orthopus/01-myohand/docs/hardware/STU-0113 - Assembly plan v1_2 [FR].xlsx

Composants | Origine | Post-opération
Arbre intermédiaire 1
Paliers | Commerce | Coupe
Plaque int | Impression ALU | Perçage - Taraudage
Arbre | Commerce | Coupe
Roue entrée | Commerce | Coupe ?
Roue héli | Commerce | Coupe ?
Support roulement sup | Impression ALU | Alésage - Taraudage
Arbre intermédiaire 2
Engrenages | Commerce | Coupe - Perçage - Assemblage
Paliers engrenages | Commerce | -
Poulie | Impression ALU | Perçage
Paliers poulie | Commerce | Coupe
Arbre | Commerce | Coupe - Perçage - Taraudage
Arbre moteur
Arbre | Commerce | Coupe - Perçage - Taraudage
Vis sans fin | Commerce | Coupe
Entretoises | Impression PLA | Impression
Roulements | Commerce | -
Support moteur
Embase | Impression ALU | Perçage - Taraudage
Moteur | Commerce | -
Support roulement inf | Impression ALU | Alésage - Taraudage
Doigts sup
Index | Impression ALU | Perçage
Renvoi cable | Impression ALU | Perçage
Engrenage sup | Commerce | Retouche
Majeur | Impression ALU | Perçage
Paliers | Commerce | -
Arbre | Commerce | Coupe - Perçage - Taraudage
Fourche
Fourche | Impression ALU | Perçage - Assemblage
Plaque ext | Impression ALU | Perçage - Taraudage
Lames élastiques | Commerce | Coupe
Pouce
Pouce | Impression ALU | Perçage - Taraudage
Paliers | Commerce | -
Arbre | Commerce | Coupe - Perçage - Taraudage
Câbles
Câbles | Commerce
