orthopus/01-myohand/src/software/firmware/MyoHand_v1_Project/custom-board-platformio/packages/framework-arduino-megaavr/variants/nona4809_custom/pins_arduino.h

/*
  pins_arduino.h - Pin definition functions for Arduino
  Part of Arduino - http://www.arduino.cc/

  Copyright (c) 2007 David A. Mellis

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
  You should have received a copy of the GNU Lesser General
  Public License along with this library; if not, write to the
  Free Software Foundation, Inc., 59 Temple Place, Suite 330,
  Boston, MA  02111-1307  USA
*/

#ifndef Pins_Arduino_h
#define Pins_Arduino_h

#include <avr/pgmspace.h>
#include "timers.h"

#define NUM_DIGITAL_PINS            22 // (14 on digital headers + 8 on analog headers)
#define NUM_ANALOG_INPUTS           14
#define NUM_RESERVED_PINS           6  // (TOSC1/2, VREF, RESET, DEBUG USART Rx/Tx)
#define NUM_INTERNALLY_USED_PINS    10 // (2 x Chip select + 2 x UART + 4 x IO + LED_BUILTIN + 1 unused pin)
#define NUM_I2C_PINS                2  // (SDA / SCL)
#define NUM_SPI_PINS                3  // (MISO / MOSI / SCK)
#define NUM_TOTAL_FREE_PINS         (NUM_DIGITAL_PINS)
#define NUM_TOTAL_PINS              (NUM_DIGITAL_PINS + NUM_RESERVED_PINS + NUM_INTERNALLY_USED_PINS + NUM_I2C_PINS + NUM_SPI_PINS)
#define ANALOG_INPUT_OFFSET         14

#define EXTERNAL_NUM_INTERRUPTS     48

#define digitalPinHasPWM(p)         ((p) == 3 || (p) == 5 || (p) == 6 || (p) == 9 || (p) == 10)

#define SPI_MUX       (PORTMUX_SPI0_ALT2_gc)
#define PIN_SPI_MISO  (12)
#define PIN_SPI_SCK   (13)
#define PIN_SPI_MOSI  (11)
#define PIN_SPI_SS    (8)

static const uint8_t SS   = PIN_SPI_SS;
static const uint8_t MOSI = PIN_SPI_MOSI;
static const uint8_t MISO = PIN_SPI_MISO;
static const uint8_t SCK  = PIN_SPI_SCK;

#define PIN_WIRE_SDA  (22)
#define PIN_WIRE_SCL  (23)

static const uint8_t SDA = PIN_WIRE_SDA;
static const uint8_t SCL = PIN_WIRE_SCL;

// Main USART available on Arduino header pins
// USART1 on mega4809 (alternative pins)
// Mapped to HWSERIAL0 in Serial library
#define HWSERIAL1 (&USART1)
#define HWSERIAL1_DRE_VECTOR (USART1_DRE_vect)
#define HWSERIAL1_DRE_VECTOR_NUM (USART1_DRE_vect_num)
#define HWSERIAL1_RXC_VECTOR (USART1_RXC_vect)
#define HWSERIAL1_MUX (PORTMUX_USART1_ALT1_gc)
#define PIN_WIRE_HWSERIAL1_RX (0)
#define PIN_WIRE_HWSERIAL1_TX (1)

// Uno2 Debug USART (not available on headers, only via the EDGB virtual COM port)
// USART3 on mega4809 (alternative pins)
// Mapped to HWSERIAL1 in Serial library
#define HWSERIAL0 (&USART3)
#define HWSERIAL0_DRE_VECTOR (USART3_DRE_vect)
#define HWSERIAL0_DRE_VECTOR_NUM (USART3_DRE_vect_num)
#define HWSERIAL0_RXC_VECTOR (USART3_RXC_vect)
#define HWSERIAL0_MUX (PORTMUX_USART3_ALT1_gc)
#define PIN_WIRE_HWSERIAL0_RX (24)
#define PIN_WIRE_HWSERIAL0_TX (25)

#define HWSERIAL2_MUX (PORTMUX_USART0_NONE_gc)
#define HWSERIAL3_MUX (PORTMUX_USART2_NONE_gc)

#define TWI_MUX (PORTMUX_TWI0_DEFAULT_gc) //PORTMUX_TWI0_ALT1_gc

#define MUX_SPI (SPI_MUX)
#define SPI_INTERFACES_COUNT 1

#define LED_BUILTIN   (13)

#define PIN_A0   (14) // AIN3
#define PIN_A1   (15) // AIN2
#define PIN_A2   (16) // AIN1
#define PIN_A3   (17) // AIN0
#define PIN_A4   (18) // PF2 / AIN12
#define PIN_A5   (19) // PF3 / AIN13
#define PIN_A6   (20) // AIN5
#define PIN_A7   (21) // AIN4

static const uint8_t A0 = PIN_A0;
static const uint8_t A1 = PIN_A1;
static const uint8_t A2 = PIN_A2;
static const uint8_t A3 = PIN_A3;
static const uint8_t A4 = PIN_A4;
static const uint8_t A5 = PIN_A5;
static const uint8_t A6 = PIN_A6;
static const uint8_t A7 = PIN_A7;

#define PINS_COUNT    (40u)

#ifdef ARDUINO_MAIN

// On the Arduino board, digital pins are also used
// for the analog output (software PWM).  Analog input
// pins are a separate set.

// ATMEGA4809 / ARDUINO
//
//                     (SCL)(SDA) (7)  (2)                 (R)  (3~) (6~)
//                 PA4  PA3  PA2  PA1  PA0  GND  VDD  UPDI PF6  PF5  PF4  PF3
//
//                  48   47   46   45   44   43   42   41   40   39   38   37
//              + ____ ____ ____ ____ ____ ____ ____ ____ ____ ____ ____ ____ +
//        PA5   1|                                                             |36  PF2
//        PA6   2|                                                             |35  PF1 (TOSC2)
//        PA7   3|                                                             |34  PF0 (TOSC1)
//   (9~) PB0   4|                                                             |33  PE3 (8)
//  (10~) PB1   5|                                                             |32  PE2 (13)
//   (5~) PB2   6|                                                             |31  PE1 (12)
//        PB3   7|                          48pin QFN                          |30  PE0 (11~)
//   (Tx) PB4   8|                                                             |29  GND
//   (Rx) PB5   9|                                                             |28  AVDD
//        PC0  10|                                                             |27  PD7 (VREF)
//        PC1  11|                                                             |26  PD6
//        PC2  12|                                                             |25  PD5 (A5)
//               + ____ ____ ____ ____ ____ ____ ____ ____ ____ ____ ____ ____ +
//                  13   14   15   16   17   18   19   20   21   22   23   24
//
//                  PC3  VDD  GND  PC4  PC5  PC6  PC7  PD0  PD1  PD2  PD3  PD4
//                                 (1)  (0)  (4)       (A0) (A1) (A2) (A3) (A4)

//

const uint8_t digital_pin_to_port[] = {
  PC, // 0 PC5/USART1_Rx
  PC, // 1 PC4/USART1_Tx
  PA, // 2 PA0
  PF, // 3 PF5
  PC, // 4 PC6
  PB, // 5 PB2
  PF, // 6 PF4
  PA, // 7 PA1
  PE, // 8 PE3
  PB, // 9 PB0
  PB, // 10 PB1
  PE, // 11 PE0
  PE, // 12 PE1
  PE, // 13 PE2
  PD, // 14 PD3/AI3
  PD, // 15 PD2/AI2
  PD, // 16 PD1/AI1
  PD, // 17 PD0/AI0
  PF, // 18 PF2/AI12
  PF, // 19 PF3/AI13
  PD, // 20 PD4/AI4
  PD, // 21 PD5/AI5
  PA, // 22 PA2/TWI_SDA
  PA, // 23 PA3/TWI_SCL
  PB, // 24 PB5/USART3_Rx
  PB, // 25 PB4/USART3_Tx
};

/* Use this for accessing PINnCTRL register */
const uint8_t digital_pin_to_bit_position[] = {
  PIN5_bp,  // 0 PC5/USART1_Rx
  PIN4_bp,  // 1 PC4/USART1_Tx
  PIN0_bp,  // 2 PA0
  PIN5_bp,  // 3 PF5
  PIN6_bp,  // 4 PC6
  PIN2_bp,  // 5 PB2
  PIN4_bp,  // 6 PF4
  PIN1_bp,  // 7 PA1
  PIN3_bp,  // 8 PE3
  PIN0_bp,  // 9 PB0
  PIN1_bp,  // 10 PB1
  PIN0_bp,  // 11 PE0
  PIN1_bp,  // 12 PE1
  PIN2_bp,  // 13 PE2
  PIN3_bp,  // 14 PD3/AI3
  PIN2_bp,  // 15 PD2/AI2
  PIN1_bp,  // 16 PD1/AI1
  PIN0_bp,  // 17 PD0/AI0
  PIN2_bp,  // 18 PF2/AI12
  PIN3_bp,  // 19 PF3/AI13
  PIN4_bp,  // 20 PD4/AI4
  PIN5_bp,  // 21 PD5/AI5
  PIN2_bp,  // 22 PA2/TWI_SDA
  PIN3_bp,  // 23 PA3/TWI_SCL
  PIN5_bp,  // 24 PB5/USART3_Rx
  PIN4_bp,  // 25 PB4/USART3_Tx
};

/* Use this for accessing PINnCTRL register */
const uint8_t digital_pin_to_bit_mask[] = {
  PIN5_bm,  // 0 PC5/USART1_Rx
  PIN4_bm,  // 1 PC4/USART1_Tx
  PIN0_bm,  // 2 PA0
  PIN5_bm,  // 3 PF5
  PIN6_bm,  // 4 PC6
  PIN2_bm,  // 5 PB2
  PIN4_bm,  // 6 PF4
  PIN1_bm,  // 7 PA1
  PIN3_bm,  // 8 PE3
  PIN0_bm,  // 9 PB0
  PIN1_bm,  // 10 PB1
  PIN0_bm,  // 11 PE0
  PIN1_bm,  // 12 PE1
  PIN2_bm,  // 13 PE2
  PIN3_bm,  // 14 PD3/AI3
  PIN2_bm,  // 15 PD2/AI2
  PIN1_bm,  // 16 PD1/AI1
  PIN0_bm,  // 17 PD0/AI0
  PIN2_bm,  // 18 PF2/AI12
  PIN3_bm,  // 19 PF3/AI13
  PIN4_bm,  // 20 PD4/AI4
  PIN5_bm,  // 21 PD5/AI5
  PIN2_bm,  // 22 PA2/TWI_SDA
  PIN3_bm,  // 23 PA3/TWI_SCL
  PIN5_bm,  // 24 PB5/USART3_Rx
  PIN4_bm,  // 25 PB4/USART3_Tx
};

const uint8_t digital_pin_to_timer[] = {
  NOT_ON_TIMER,  // 0 PC5/USART1_Rx
  NOT_ON_TIMER,  // 1 PC4/USART1_Tx
  NOT_ON_TIMER,  // 2 PA0
  TIMERB1,       // 3 PF5
  NOT_ON_TIMER,  // 4 PC6
  TIMERA0,       // 5 PB2
  TIMERB0,       // 6 PF4
  NOT_ON_TIMER,  // 7 PA1
  NOT_ON_TIMER,  // 8 PE3
  TIMERA0,       // 9 PB0
  TIMERA0,       // 10 PB1
  NOT_ON_TIMER,  // 11 PE0
  NOT_ON_TIMER,  // 12 PE1
  NOT_ON_TIMER,  // 13 PE2
  NOT_ON_TIMER,  // 14 PD3/AI3
  NOT_ON_TIMER,  // 15 PD2/AI2
  NOT_ON_TIMER,  // 16 PD1/AI1
  NOT_ON_TIMER,  // 17 PD0/AI0
  NOT_ON_TIMER,  // 18 PF2/AI12
  NOT_ON_TIMER,  // 19 PF3/AI13
  NOT_ON_TIMER,  // 20 PD4/AI4
  NOT_ON_TIMER,  // 21 PD5/AI5
  NOT_ON_TIMER,  // 22 PA2/TWI_SDA
  NOT_ON_TIMER,  // 23 PA3/TWI_SCL
  NOT_ON_TIMER,  // 24 PB5/USART3_Rx
  NOT_ON_TIMER,  // 25 PB4/USART3_Tx
};

const uint8_t analog_pin_to_channel[] = {
  3,
  2,
  1,
  0,
  12,
  13,
  4,
  5
};

#endif

#define digitalPinToAnalogInput(p)  ((p < ANALOG_INPUT_OFFSET) ? analog_pin_to_channel[p] : analog_pin_to_channel[p - ANALOG_INPUT_OFFSET] )

// These serial port names are intended to allow libraries and architecture-neutral
// sketches to automatically default to the correct port name for a particular type
// of use.  For example, a GPS module would normally connect to SERIAL_PORT_HARDWARE_OPEN,
// the first hardware serial port whose RX/TX pins are not dedicated to another use.
//
// SERIAL_PORT_MONITOR        Port which normally prints to the Arduino Serial Monitor
//
// SERIAL_PORT_USBVIRTUAL     Port which is USB virtual serial
//
// SERIAL_PORT_LINUXBRIDGE    Port which connects to a Linux system via Bridge library
//
// SERIAL_PORT_HARDWARE       Hardware serial port, physical RX & TX pins.
//
// SERIAL_PORT_HARDWARE_OPEN  Hardware serial ports which are open for use.  Their RX & TX
//                            pins are NOT connected to anything by default.
#define SERIAL_PORT_MONITOR       Serial
#define SERIAL_PORT_HARDWARE      Serial1
#define SERIAL_PORT_USBVIRTUAL    Serial

#endif
