orthopus/01-myohand/src/software/firmware/MyoHand_v1_Project/include/BiDirectionSensor.h

#ifndef BIDIRECTIONSENSOR_H
#define BIDIRECTIONSENSOR_H

/* --- VirtualSensor Class Definition ---
AUTHOR : Come BUTIN
COMPANY : ORTHOPUS

This class is implemented to emulate an analogInput
to test the code and debug it. Data are stored in arrays
and can be found in TestValues.h
*/

#include "Sensor.h"
#include <Arduino.h>

class BiDirectionSensor : public Sensor {

private:
  const uint8_t inactive_pin;
  const bool direction;
  const uint16_t middle_value;
  uint16_t acquired_value = 0;

public:
  BiDirectionSensor(const bool dir, const uint16_t mid_val, const uint8_t pin,
                    const uint8_t inactive_pin, const float unit_per_dgt = 1.0);
  void setPin();
  void acquire();
  uint16_t getAcquiredValue();
};

#endif
