orthopus/01-myohand/src/software/firmware/MyoHand_v1_Project/include/TestValues.h

#ifndef TESTVALUES_H
#define TESTVALUES_H

#include <stdint.h>

#define ARRAY_SIZE 1001

const uint16_t emgO_array[1001] = {
    0,   0,   0,   0,   0,   0,   0,   0,   0,   0,   0,   0,   0,   0,   0,
    0,   0,   0,   0,   0,   0,   0,   0,   0,   0,   0,   0,   0,   0,   0,
    0,   0,   0,   0,   0,   0,   0,   0,   0,   0,   0,   0,   0,   0,   0,
    0,   0,   0,   0,   0,   0,   0,   0,   0,   0,   0,   0,   0,   0,   0,
    0,   0,   0,   0,   0,   0,   0,   0,   0,   0,   0,   0,   0,   0,   0,
    0,   0,   0,   0,   0,   0,   0,   0,   0,   0,   0,   0,   0,   3,   5,
    8,   11,  15,  18,  23,  27,  32,  37,  42,  48,  54,  60,  66,  72,  79,
    86,  93,  100, 108, 115, 123, 131, 139, 147, 155, 163, 171, 179, 187, 196,
    204, 212, 221, 229, 237, 245, 254, 262, 270, 278, 285, 293, 301, 308, 315,
    322, 329, 336, 342, 349, 355, 360, 366, 371, 376, 381, 386, 390, 394, 397,
    400, 403, 405, 407, 408, 409, 410, 410, 411, 411, 411, 410, 410, 409, 408,
    407, 406, 405, 404, 403, 402, 402, 401, 401, 401, 402, 402, 403, 404, 406,
    407, 409, 412, 414, 417, 420, 423, 427, 431, 436, 440, 445, 450, 456, 461,
    467, 473, 478, 484, 491, 497, 503, 509, 516, 522, 529, 535, 542, 549, 555,
    562, 569, 576, 582, 589, 595, 602, 608, 615, 621, 628, 634, 640, 646, 652,
    657, 663, 669, 674, 679, 684, 689, 693, 698, 702, 706, 710, 713, 717, 720,
    723, 725, 727, 729, 731, 732, 733, 734, 735, 735, 734, 734, 733, 732, 731,
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
    757, 757, 757, 757, 757, 757, 757, 757, 757, 757, 757, 757, 757, 757, 757,
    757, 757, 757, 757, 757, 757, 757, 757, 757, 757, 757, 757, 757, 757, 757,
    757, 757, 757, 757, 757, 757, 757, 757, 757, 757, 757, 757, 757, 757, 757,
    757, 757, 757, 757, 757, 757, 757, 757, 757, 757, 757, 757, 757, 757, 757,
    757, 757, 757, 757, 757, 757, 757, 757, 757, 757, 757, 757, 757, 757, 757,
    757, 757, 757, 757, 757, 757, 757, 757, 757, 757, 757, 757, 757, 757, 757,
    757, 757, 757, 757, 757, 757, 757, 757, 757, 757, 757, 757, 757, 757, 757,
    757, 757, 757, 757, 757, 757, 757, 757, 757, 757, 757, 757, 757, 757, 757,
    757, 757, 757, 757, 757, 757, 757, 757, 757, 757, 757, 757, 757, 757, 757,
    757, 757, 757, 757, 757, 757, 757, 757, 757, 757, 757, 757, 757, 757, 757,
    757, 757, 757, 757, 757, 757, 757, 757, 757, 757, 757, 757, 757, 757, 757,
    757, 757, 757, 757, 757, 757, 757, 757, 757, 757, 757, 757, 757, 757, 757,
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
#endif
