orthopus/01-myohand/(commit log)

2021-01-22 base files
    [M-0113-1101-inner_chassis.stl, M-0113-1102-outer_chassis.stl, M-0113-1112-motor_holder.stl, M-0113-1121_driver_holder.stl, M-0113-1122_arduino_holder.stl, M-0113-1130-carter.stl, M-0113-1200-upper_cable_winder.stl, M-0113-1201-outer_upper_finger_body.stl]
2021-02-19 myohand V1
    [M-0113-1101-inner_chassis.stl, M-0113-1102-outer_chassis.stl, M-0113-1112-motor_holder.stl, M-0113-1121_driver_holder.stl, M-0113-1122_arduino_holder.stl, M-0113-1130-carter.stl, M-0113-1200-upper_cable_winder.stl, M-0113-1201-outer_upper_finger_body.stl]
2021-03-09 Add BOM as CSV
    [0113-BOM.csv]
